paolometeo/MiniReteLoRa/TX_Generic_LoRa/AltDelay.ino

void altDelay(uint32_t Period){
     float TimePassed = 0;
     float TimeOld2 = 0;     
     TimeOld2 = millis();
     TimePassed = millis()-TimeOld2;
     while(TimePassed < Period){
         TimePassed = millis()-TimeOld2;
//         wdt_reset();
     }
}
