paolometeo/MiniReteLoRa/TX_Generic_LoRa/Transmit.ino

void Transmit(){

//  read battery voltage
  uint16_t vBatTX = Battery(); 
  
  // Build the buf array
  buf[0]=lowByte(ID_TX);
  buf[1]=highByte(ID_TX);
  buf[2]=lowByte(Length);
  buf[3]=highByte(Length);
  buf[4]=lowByte(vBatTX);
  buf[5]=highByte(vBatTX);
  buf[6]=lowByte(npacket);
  buf[7]=highByte(npacket);

//  fill the buf array with the variable array
for(uint16_t i = 8; i < Length; i++){
  buf[i] = minni.bufVar[i-8];
}
  
/* Transmission

Writing
Write data to the packet. Each packet can contain up to 255 bytes.
```arduino LoRa.write(byte);
LoRa.write(buffer, length); ``` * byte - single byte to write to packet
or
•buffer - data to write to packet
•length - size of data to write
Returns the number of bytes written.
Note: Other Arduino Print API's can also be used to write data into the packet
*/
  if(ECHO)Serial.println("Sending...");
//  rf95.send((uint8_t *)buf, Length);
if(ECHO)Serial.println(millis());
  LoRa.beginPacket();                   // start packet
//  LoRa.print(outgoing);                 // add payload
//  for(uint16_t i = 0; i < Length; i++){
     LoRa.write(buf, Length); //``` * byte - single byte to write to packet
  LoRa.endPacket();                     // finish packet and send it
  if(ECHO)Serial.println(millis());

  altDelay(10);
//  if(ECHO)Serial.println(F("Waiting for packet to complete...")); 
//  rf95.waitPacketSent();
  if(ECHO)Serial.println(F(" packet complete "));
  if(ECHO){
    Serial.print(" Message HEX     ");
    for(uint16_t g = 0; g < Length; g++){
       Serial.print(buf[g],HEX);Serial.print(" ");
    }
    Serial.println();
    Serial.print(F(" Message Decimal "));
    Serial.print(ID_TX);Serial.print(" ");Serial.print(Length);Serial.print(" ");
    Serial.print(vBatTX);Serial.print(" ");Serial.print(npacket);Serial.print(" ");
     Serial.println();
  }
  //  increase the packet number
  npacket++;
  if(npacket > 60000){
    npacket = 0;
  }

// Blinking
  Blinking();
}
