paolometeo/MiniReteLoRa/RX_Generic_Autoconnect_Milano_V4/ServerConfig.h

/************************ Adafruit IO Config *******************************/
//  WiFi network
// These constants  must be uppercase

//  Connection to the WiFi
#define WIFI_SSID   ""      
#define WIFI_PASS   ""

//  Adafruit access
// visit io.adafruit.com if you need to create an account,
// or if you need your Adafruit IO key.
/*
#define IO_USERNAME  "xxxxxx"
#define IO_KEY       "xxxxxx"
*/
