paolometeo/MiniReteLoRa/RepeaterGeneric/Action.ino

void Action(){

//  Identification and re-transmission 
         if(ID_TX == ID1){
            if(ECHO){
              Serial.println();
              Serial.print("       Received ");Serial.println(ID_TX);
              Serial.println();
            }
            Print12127();
            ID_TX = 12128;
            rf95.setFrequency(RF95_FREQ_RIP);
            if(ECHO){
              Serial.println();
              Serial.print("       Transmitted ");Serial.println(ID_TX);
              Serial.println();
            }
            if (ECHO) {
                 Serial.print("Set Freq to: "); Serial.println(RF95_FREQ_RIP);
            }
            Transmit();
         }else{
            if(ECHO){
               Serial.println(" ID_TX not permitted ");
            }
         }
      }
