paolometeo/MiniReteLoRa/RX_Generic_Autoconnect/Action.ino

void Action(){

//  Identification and re-transmission 
               if(ID_TX == ID0){
              Print12127();
         }else if(ID_TX == ID1){
              Print12130();
         }else if(ID_TX == ID2){
              Print12140();
         }else if(ID_TX == ID3){
              Print30002();
        }else if(ID_TX == ID4){
              Print30003();
        }else if(ID_TX == ID5){
              Print50000();
         }else{
               Serial.println(" ID_TX not permitted ");
         }
      }
